DanielMontecino/SISPO/(commit log)

2018-12-09 Add a measure of position with 4 sensors and 4 transmisors HX711
2018-12-10 La importante en visualizacion esta en:
    vgax-master----->examples------>Imagenfondo
    Hay dos funciones de circulo, una que solo plotea un circulo, pero no sirve, debido a que solo grafica un circulo, pero no en una posicion x,y (circulo.cpp)
    La otra es util, circulo2.cpp, se especifica x,y y radio y lo plotea en el lugar indicado
2018-12-11 Add 8 sensors measure with 8 HX711 Add a GUI that draws a circle in the screen
2018-12-16 +codigo arduino
2018-12-16 arduino flag
